symat/tiny-gameboy/schema/Schematic_tiny-gameboy-lipo-tht_2022-01-27.pdf

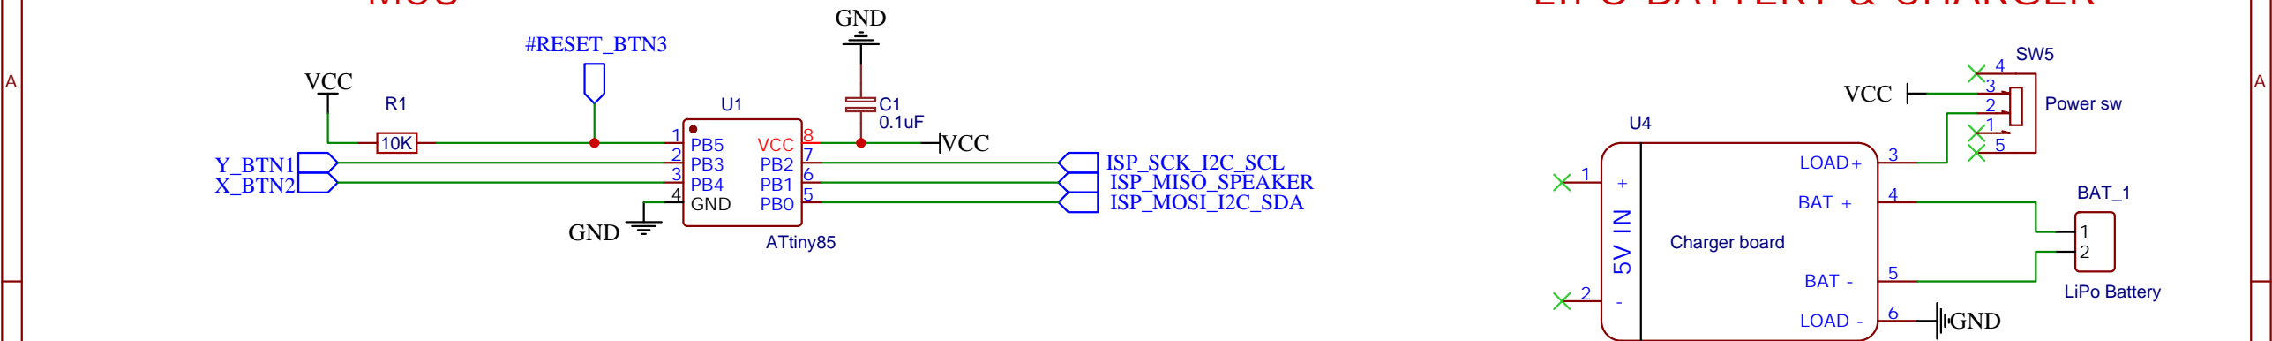
[picture p1: figure]
#RESET_BTN3; VCC; GND; ISP_SCK_I2C_SCL; ISP_MOSI_I2C_SDA; ISP_MISO_SPEAKER; LiPo Battery; BAT_1; ATtiny85; U1 PB5 1 PB3 2 PB4 3 GND 4; VCC 8; Y_BTN1 X_BTN2; Charger board; LOAD+ 3; BAT +; BAT -; LOAD -; Power sw
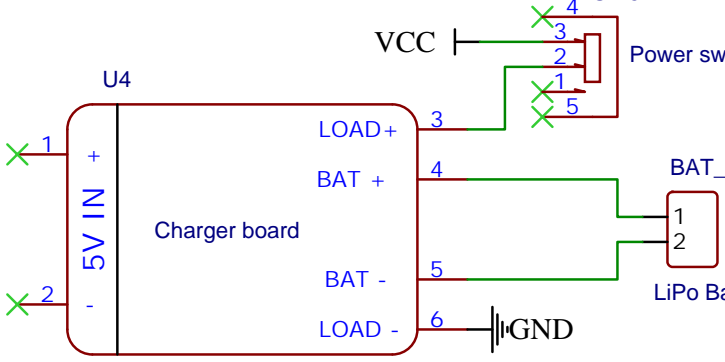
[picture p2: figure]
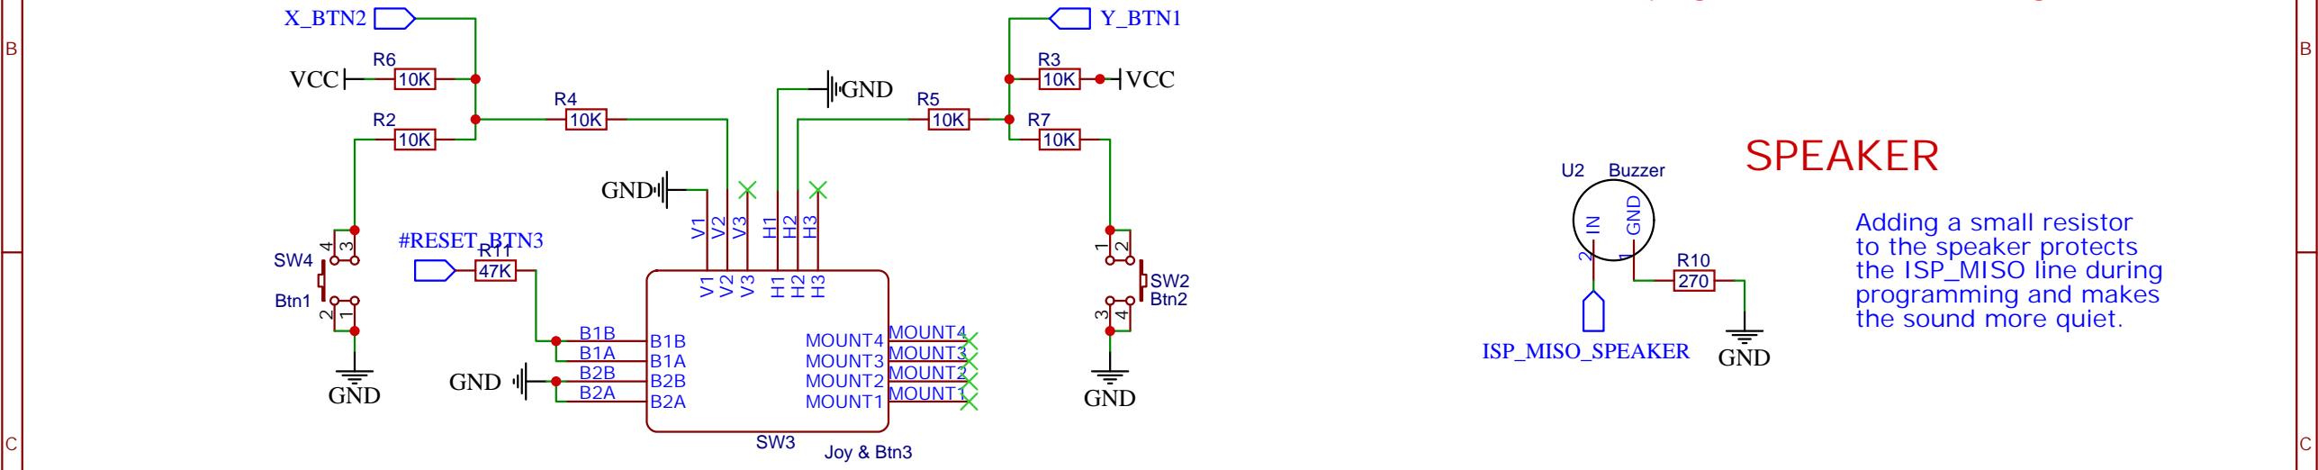
[picture p3: figure]
U2 Buzzer GND; GND; SPEAKER; Joy & Btn3 SW3; Btn1; VCC; Btn2; ISP_MISO_SPEAKER; X_BTN2; Y_BTN1; Adding a small resistor to the speaker protects the ISP_MISO line during programming and makes the sound more quiet.; #RESET_BTN3 47K

D | D

1

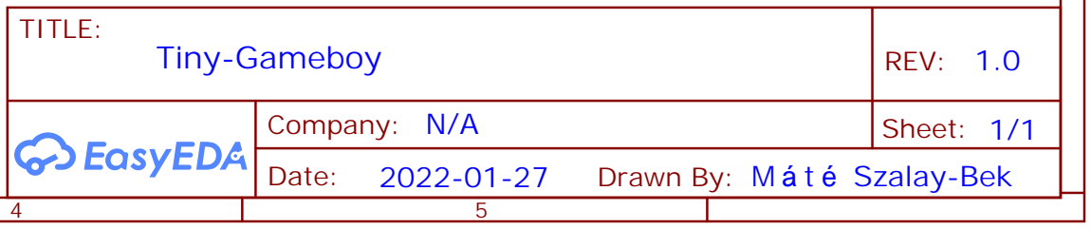
[picture p4: figure]
TITLE:; Tiny-Gameboy; REV: 1.0; Date:; Sheet: 1/1 Drawn By: M t Szalay-Bek; Company: N/A

1

2

2

3

3

4

5

ISP_MISO_SPEAKER
ISP_MOSI_I2C_SDA

ISP_SCK_I2C_SCL

#RESET_BTN3

GND

VCC

# ISP PROGRAMMER CONNECTOR

# LIPO BATTERY & CHARGER

MOUNT1 MOUNT1 MOUNT2 MOUNT2 MOUNT3 MOUNT3 MOUNT4 MOUNT4

The joystick has an extra button, we connect it to the #RESET PIN using a larger resistor so we don't bring the #RESET line down fully.

ISP_SCK_I2C_SCL
ISP_MOSI_I2C_SDA

GND

#RESET_BTN3

# DISPLAY CONNECTOR

# BUTTONS & JOYSTICK

# MCU

ISP6

CON_1

5V

2

MOSI/D11

4

MISO/D12

1

SCK/D13

3

RST

5

GND

6

VCC

DISPLAY

CON_2
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
The display must not drive the ISP lines during programming. The programmer will pull down the #RESET line, so we can use this to disable the display when the programmer is active. Standard I2C OLED modules usually have 4 PINs only and don't have a #RESET PIN, but the #RESET of the display controller is connected to GND with a small capacitor. You should remove the capacitor (to make the ISP programmer more stable) and then manually connect the #RESET PIN of the display controller with the #RESET line on the board.

Always turn-off the power before connecting the ISP programmer or the USB charger!
