symat/tiny-gameboy/schema/Schematic_tiny-gameboy_2022-01-27.pdf

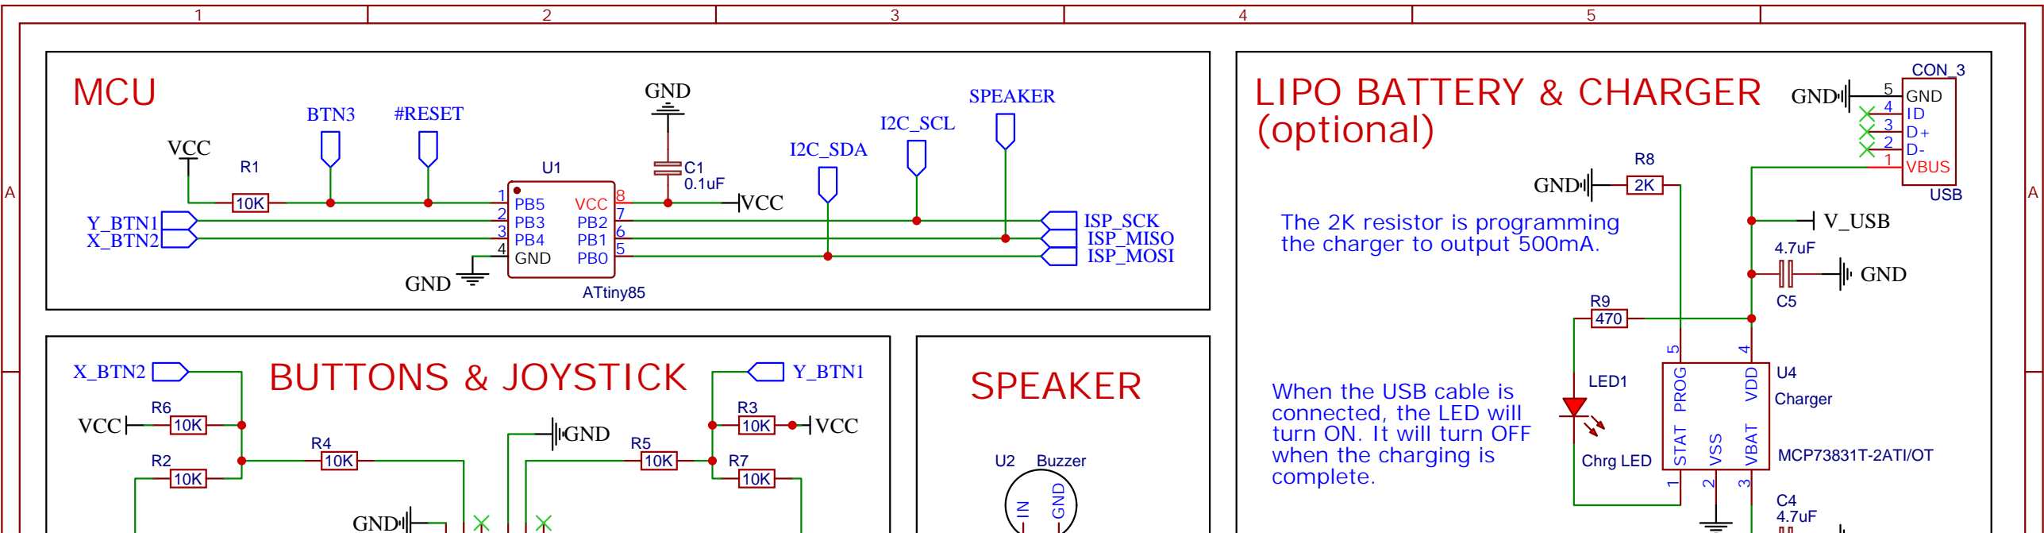
[picture p5: figure]
USB; CON_3; VBUS; GND; 3 VDD; PROG; U2 Buzzer GND; #RESET; VCC; ISP_SCK; ISP_MOSI; ISP_MISO; GND The 2K resistor is programming the charger to output 500mA.; When the USB cable is connected, the LED will turn ON. It will turn OFF when the charging is complete.; SPEAKER; LIPO BATTERY & CHARGER (optional); Chrg LED; LED1; ATtiny85; U1 PB5 1 PB3 2 PB4 3 GND 4; VCC 8; V_USB; I2C_SCL; I2C_SDA; Y_BTN1 X_BTN2; X_BTN2; BUTTONS & JOYSTICK; Y_BTN1; MCU; MCP73831T-2ATI/OT; BTN3
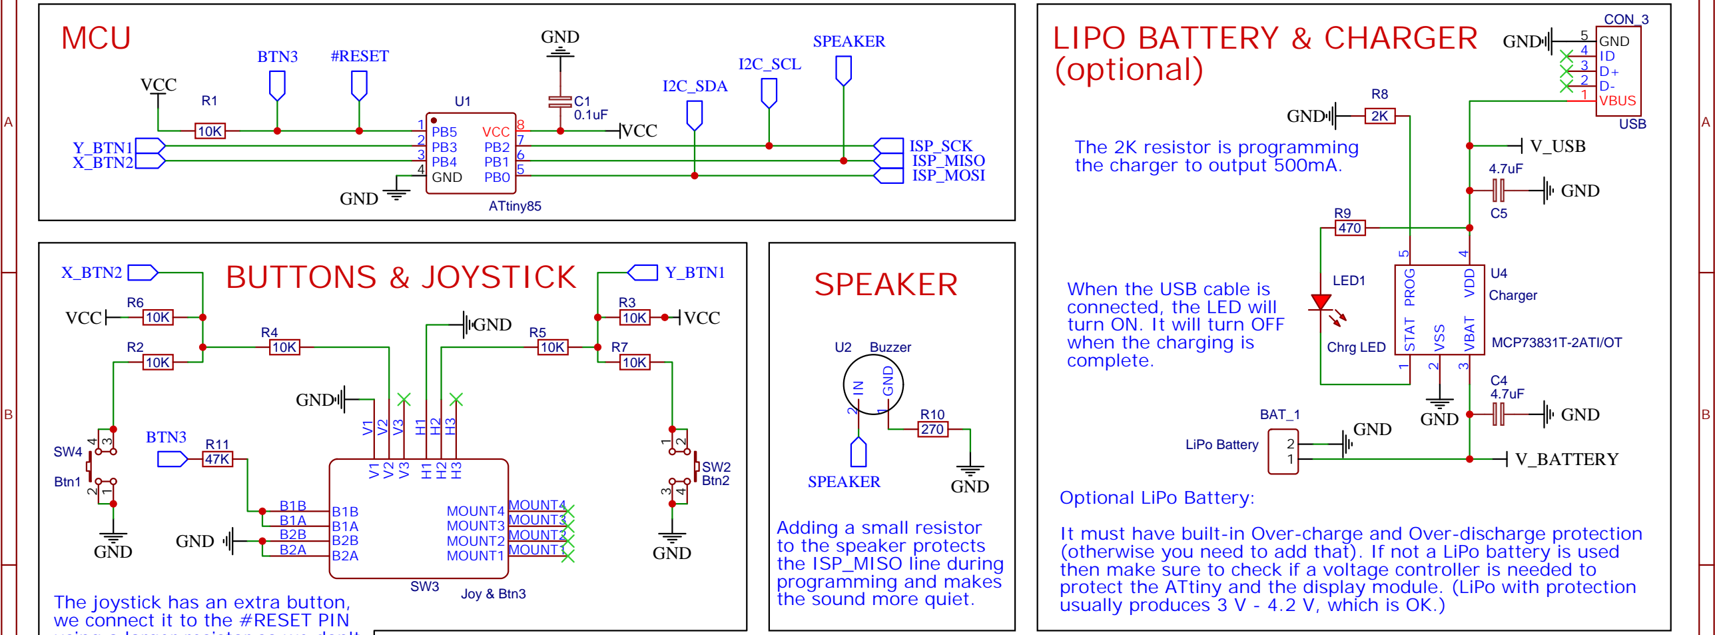
[picture p6: figure]
Charger; STAT; VSS; VBAT; GND; LiPo Battery; BAT_1; V_BATTERY; Joy & Btn3 SW3; The joystick has an extra button, we connect it to the #RESET PIN; Btn1; Btn2; SPEAKER; Adding a small resistor to the speaker protects the ISP_MISO line during programming and makes the sound more quiet.; BTN3; Optional LiPo Battery:
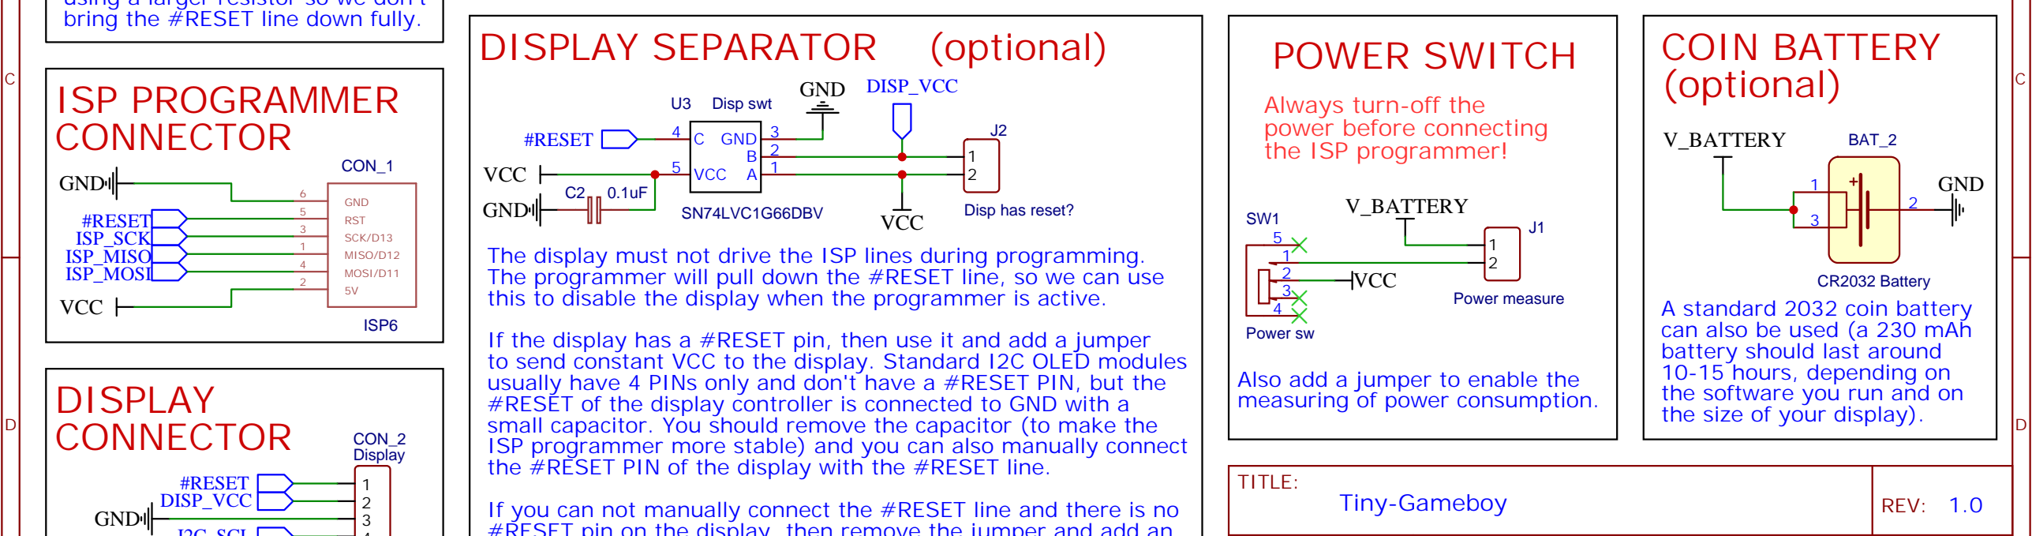
[picture p7: figure]
TITLE:; Tiny-Gameboy; REV: 1.0; ISP_MISO ISP_MOSI; ISP_SCK; #RESET; GND; VCC; ISP PROGRAMMER CONNECTOR; Power sw; bring the #RESET line down fully.; Display; CON_2; U3 Disp swt; GND 3 C; VCC 5; Disp has reset?; DISP_VCC; DISPLAY CONNECTOR; DISPLAY SEPARATOR (optional); V_BATTERY; POWER SWITCH; Always turn-off the power before connecting the ISP programmer!; COIN BATTERY (optional); A standard 2032 coin battery can also be used (a 230 mAh battery should last around 10-15 hours, depending on the software you run and on the size of your display).; CR2032 Battery; BAT_2; Power measure; Also add a jumper to enable the measuring of power consumption.; ISP6; CON_1; MOSI/D11; MISO/D12; SCK/D13; RST; SN74LVC1G66DBV
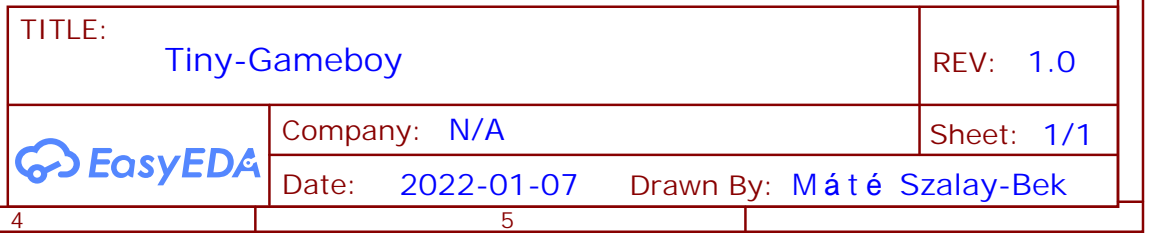
[picture p8: figure]
Date:; Sheet: 1/1 Drawn By: M t Szalay-Bek; Company: N/A

1

2

3

MOUNT1 MOUNT1 MOUNT2 MOUNT2 MOUNT3 MOUNT3 MOUNT4 MOUNT4

using a larger resistor so we don't

The display must not drive the ISP lines during programming. The programmer will pull down the #RESET line, so we can use this to disable the display when the programmer is active.
If the display has a #RESET pin, then use it and add a jumper to send constant VCC to the display. Standard I2C OLED modules usually have 4 PINs only and don't have a #RESET PIN, but the #RESET of the display controller is connected to GND with a small capacitor. You should remove the capacitor (to make the ISP programmer more stable) and you can also manually connect the #RESET PIN of the display with the #RESET line.
If you can not manually connect the #RESET line and there is no #RESET pin on the display, then remove the jumper and add an analogue switch to enable the display VCC only if #RESET is high.

I2C_SCL
I2C_SDA

4
5

It must have built-in Over-charge and Over-discharge protection (otherwise you need to add that). If not a LiPo battery is used then make sure to check if a voltage controller is needed to protect the ATtiny and the display module. (LiPo with protection usually produces 3 V - 4.2 V, which is OK.)
