symat/tiny-gameboy/dragon-clipart-large.png

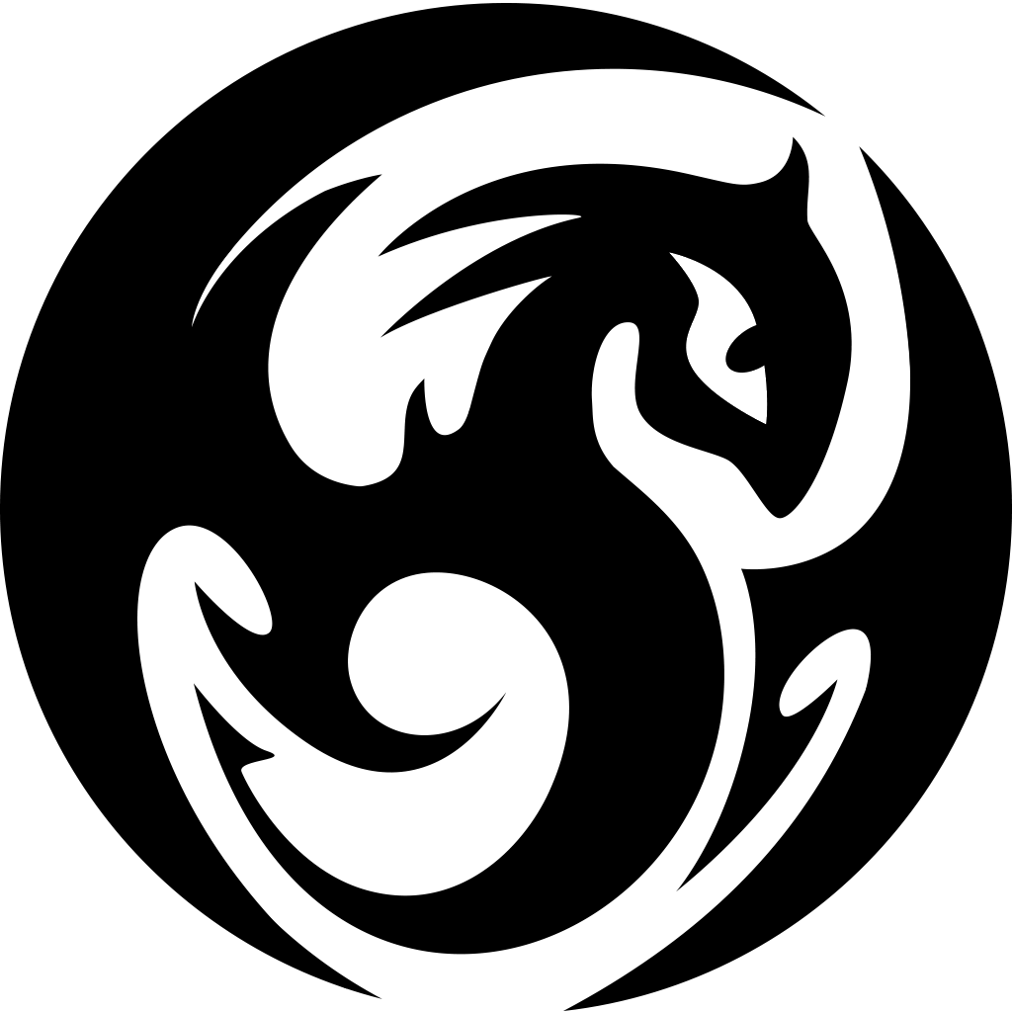
dragon-clipart-large.png
