symat/tiny-gameboy/joystick.png

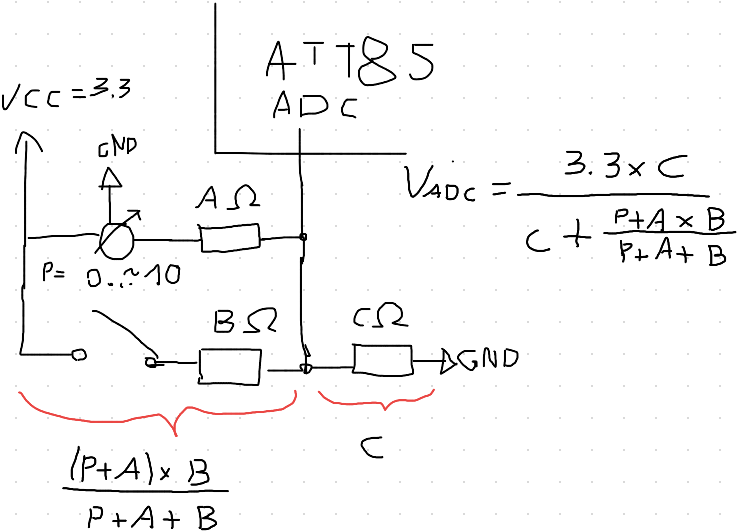
joystick.png
