symat/tiny-gameboy/arduino_workspace/snake/image.h

#define SNAKE_IMAGE_WIDTH 56
#define SNAKE_IMAGE_HEIGHT 56


// 'snake_logo', 56x56px
const unsigned char snake_image[] PROGMEM = {
  0x00, 0x00, 0x00, 0x00, 0x00, 0x00, 0x00, 0x00, 0x00, 0x00, 0x00, 0x00, 0x00, 0x00, 0x00, 0x00, 
  0x00, 0x00, 0x80, 0x80, 0x40, 0xe0, 0x18, 0x0c, 0x04, 0x24, 0x64, 0x64, 0x0a, 0xf1, 0x01, 0x19, 
  0x19, 0x9b, 0xc6, 0xbc, 0x80, 0x00, 0x00, 0x00, 0x00, 0x00, 0x00, 0x00, 0x00, 0x00, 0x00, 0x00, 
  0x00, 0x00, 0x00, 0x00, 0x00, 0x00, 0x00, 0x00, 0x00, 0x00, 0x00, 0x00, 0x00, 0x00, 0x00, 0x00, 
  0x00, 0x00, 0x00, 0x80, 0xc0, 0x30, 0x18, 0x04, 0x02, 0x01, 0x01, 0x00, 0x00, 0x01, 0x03, 0x04, 
  0xc4, 0x04, 0x04, 0x04, 0x02, 0x01, 0x01, 0x01, 0x01, 0x01, 0x00, 0x00, 0x00, 0x01, 0x83, 0x06, 
  0x1c, 0xf0, 0x00, 0x00, 0x00, 0x00, 0x00, 0x00, 0x00, 0x00, 0x00, 0x00, 0x00, 0x00, 0x00, 0x00, 
  0x00, 0x00, 0x00, 0x00, 0x00, 0x00, 0x00, 0x00, 0x00, 0x00, 0xfc, 0x03, 0x00, 0x00, 0x00, 0x00, 
  0x00, 0x00, 0xf8, 0x04, 0x02, 0x01, 0x01, 0x02, 0x04, 0x09, 0x0a, 0x0c, 0x0c, 0x08, 0x08, 0x18, 
  0x10, 0xf0, 0x60, 0x88, 0x08, 0x09, 0x04, 0x04, 0x03, 0x00, 0x00, 0x00, 0x00, 0x00, 0x00, 0x00, 
  0x00, 0x00, 0x00, 0x00, 0x00, 0x00, 0x00, 0x00, 0x00, 0x00, 0x00, 0x00, 0x00, 0x00, 0x00, 0x00, 
  0x00, 0x00, 0x07, 0x18, 0x20, 0x40, 0x80, 0x00, 0x00, 0x00, 0x01, 0x06, 0x08, 0x10, 0x20, 0x20, 
  0x40, 0x40, 0x40, 0x80, 0x80, 0x80, 0x00, 0x00, 0x00, 0x01, 0x03, 0x03, 0x00, 0x00, 0x00, 0x00, 
  0x00, 0x00, 0x00, 0x00, 0x03, 0x06, 0x1c, 0x78, 0xb0, 0x40, 0x80, 0x00, 0x00, 0x00, 0x00, 0x00, 
  0x00, 0x00, 0x00, 0x00, 0x80, 0x40, 0x40, 0x40, 0x40, 0x40, 0xc0, 0xc0, 0x40, 0x40, 0x80, 0x81, 
  0x82, 0x82, 0x04, 0x08, 0x08, 0x10, 0x10, 0x20, 0x20, 0x40, 0x80, 0x00, 0x00, 0x00, 0x01, 0x01, 
  0x02, 0x02, 0x04, 0x08, 0x30, 0xc0, 0x00, 0x00, 0x00, 0x00, 0x00, 0x00, 0x00, 0x00, 0x00, 0x00, 
  0xff, 0x00, 0x01, 0x06, 0x78, 0x00, 0x00, 0x00, 0x00, 0x00, 0x00, 0x3f, 0x40, 0x80, 0x00, 0x00, 
  0x00, 0x00, 0x00, 0x00, 0x01, 0x02, 0x02, 0x04, 0x08, 0x08, 0x11, 0x11, 0x21, 0x22, 0x62, 0x46, 
  0x44, 0x64, 0x28, 0x29, 0x1e, 0x00, 0x00, 0x00, 0x00, 0x00, 0x00, 0x00, 0x00, 0xc0, 0x3e, 0x20, 
  0x20, 0x10, 0x10, 0x18, 0x08, 0x04, 0x06, 0x03, 0x00, 0x80, 0xc0, 0x30, 0x0f, 0x00, 0x00, 0x00, 
  0x00, 0x00, 0x00, 0x00, 0x00, 0x00, 0x01, 0x02, 0x06, 0x04, 0x08, 0x18, 0x10, 0x20, 0x20, 0x40, 
  0x40, 0x40, 0x80, 0x80, 0x80, 0x80, 0x80, 0x80, 0x80, 0x80, 0x80, 0x80, 0x80, 0x40, 0x40, 0x40, 
  0x60, 0x90, 0x98, 0x8c, 0x42, 0x41, 0x40, 0x40, 0x40, 0x20, 0x20, 0x10, 0x10, 0x08, 0x0c, 0x06, 
  0x03, 0x01, 0x00, 0x00, 0x00, 0x00, 0x00, 0x00
};


#define TILE_HEIGHT 5
#define TILE_WIDTH 5

static const byte snake_tile[] PROGMEM = {
  B00011111, 
  B00011011,
  B00010101,
  B00011011,
  B00011111
};

static const byte food_tile[] PROGMEM = {
  B00010001, 
  B00001010,
  B00000100,
  B00001010,
  B00010001
};

static const byte brick_tile[] PROGMEM = {
  B00011111, 
  B00010001, 
  B00010001, 
  B00010001, 
  B00011111
};


#define SPEED_ICON_HEIGHT 7
#define SPEED_ICON_WIDTH 6


static const byte speed_icon[] PROGMEM = {
  B01111111, 
  B00100010, 
  B00100010, 
  B00010100, 
  B00010100, 
  B00001000 
};

static const byte speed_icon_full[] PROGMEM = {
  B01111111, 
  B00111110, 
  B00111110, 
  B00011100, 
  B00011100, 
  B00001000 
};


static const byte speed_icon_full_reverse[] PROGMEM = {
  B00001000,
  B00011100, 
  B00011100, 
  B00111110, 
  B00111110, 
  B01111111 
};

#define MUSIC_ICON_WIDTH 8
#define MUSIC_ICON_HEIGHT 8
#define MUSIC_ICON_X 117
#define MUSIC_ICON_Y 41

static const byte music_on[] PROGMEM = {
  B00111100, 
  B00111100, 
  B00111100, 
  B01111110, 
  B11111111,
  B00000000,
  B00000000,
  B00000000
};

static const byte music_off[] PROGMEM = {
  B00111100, 
  B00111100, 
  B00111100, 
  B01000010, 
  B10000001,
  B00100100,
  B00011000,
  B00100100
};
